djacobow/pidog2/hardware/v0.7/lshift_pulldown.pdf

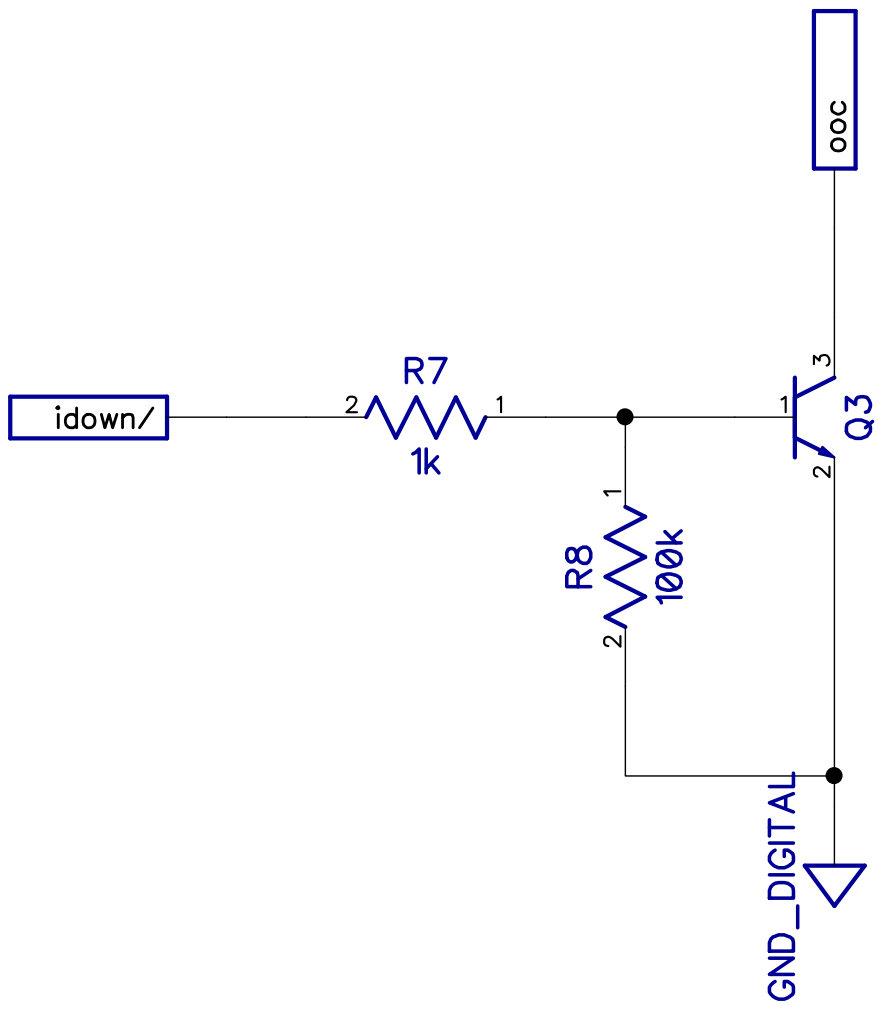
[picture p1: page 1]
