djacobow/pidog2/hardware/v0.7/pswitch.pdf

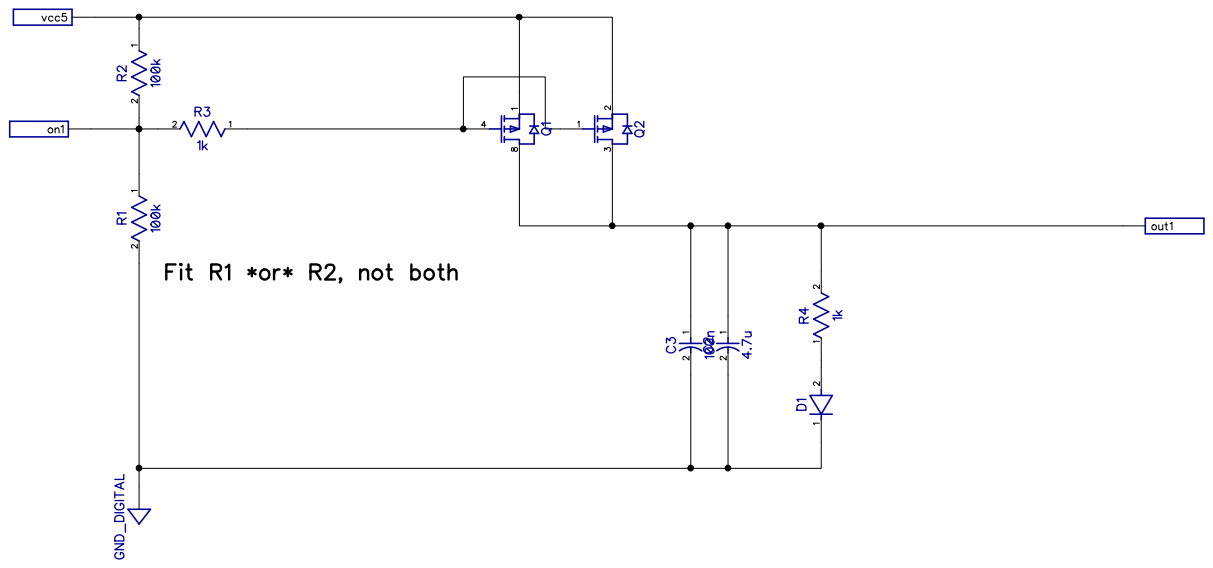
[picture p2: page 1]
