djacobow/pidog2/hardware/v0.7/top.pdf

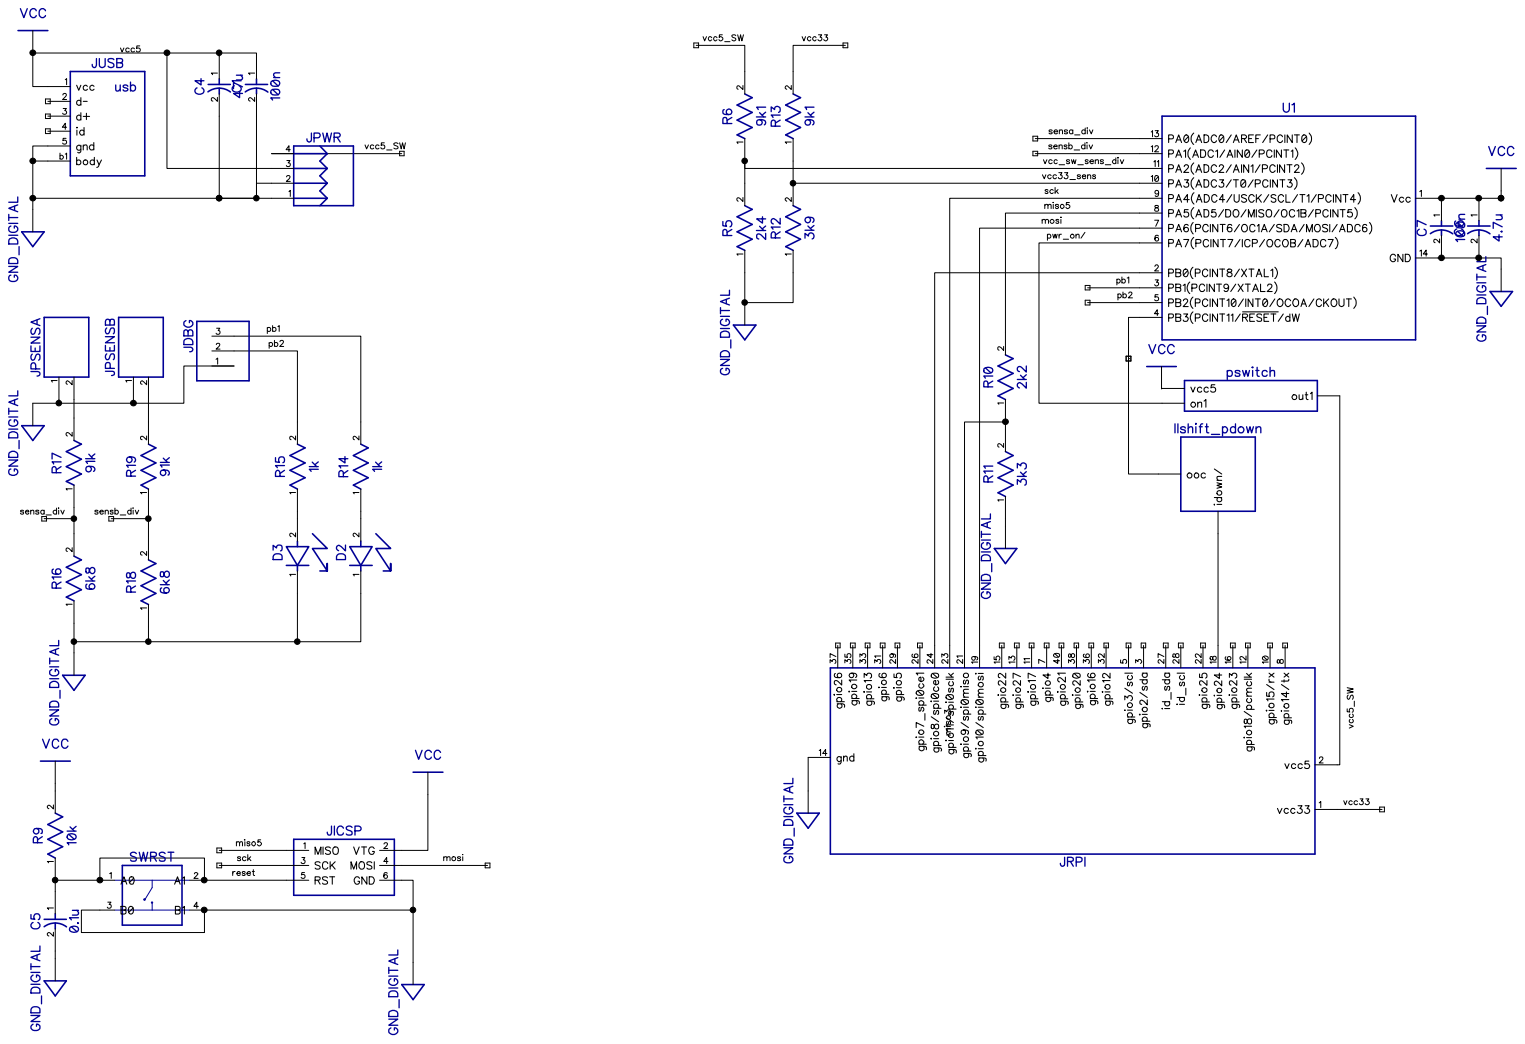
[picture p3: page 1]
