djacobow/pidog2/(commit log)

2018-09-08 check for device id
2018-09-08 put device id "pd" into the hw register
2018-09-09 set proper signal polarity for power on/off
2018-09-10 adjust for negative polarity on the reset pin
2018-09-10 for testing spi/programming connection
2018-09-13 try to reduce power use with sleep mode between ticks
2018-09-14 move voltage measurement adjustments to rpi
2018-09-15 these will not work, but keeping them around in case I think of something clever
2018-09-15 sleep mostly when off to save power!
2018-09-26 rearrange registers a bit and use resistor ratios to calculate voltage estimates
2018-09-26 fuse settings
2018-10-01 name the first led, leave the second led out for users
2018-10-11 do not hold the MISO bus when we are not using it -- allow other SPI devices
2018-10-13 insert note on pin order
2018-11-08 schematic for v0.7
2021-01-26 PR for low-voltage disconnect and high-voltage reconnect feature. (#2)
    * Added support for new register 'vsensa_on_threshold', which is the threshold voltage at which the pidog will re-apply power to the rpi after the 'off_remaining' timer has expired.
    * Added support for high-voltage reconnect threshold
    Added a new register REG_VSENSA_ON_THRESHOLD, which defaults to '0'. Modified the doSecondWork() function to check if the VSENSA voltage is greater than or equal to the ON threshold value in the code block that handles the power off state and an expired 'OFF_REMAINIG' timer.
    Succesfully tested that I can set/det this register but then bricked my pidog when trying to reprogram it whi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
2021-02-06 dgj/hard reset (#4)
    * implement hard reset, fix v33 bug
    * arrange register for backward compat
    * update firmware images
    [adcReader.h, dogcmd.py, pidog.py, pidog2.ino, spi_reg_names.h]
2021-02-10 PR for soft-start power, MCUSR access, and logging (#5)
    Succesfully tested that I can set/det this register but then bricked my pidog when trying to reprogram it while also running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
2021-02-27 Bug fix for LVDC/HVRC feature where pidog would unexpectedly kill power to rpi (#7)
    Succesfully tested that I can set/det this register but then bricked my pidog when trying to rep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
    [adcReader.h, ema.h, pidog2.ino]
